abfouts/ECE_411/README.md

# ECE_411 :: T08 
Group Practicum Project
