abfouts/ECE_411/brd/README

This is the folder with the versions of the board schematic and board files
