abfouts/ECE_411/Documentation/AirplaneLGear_HW5_blockdiagrams.pdf

# High Level Block Diagram

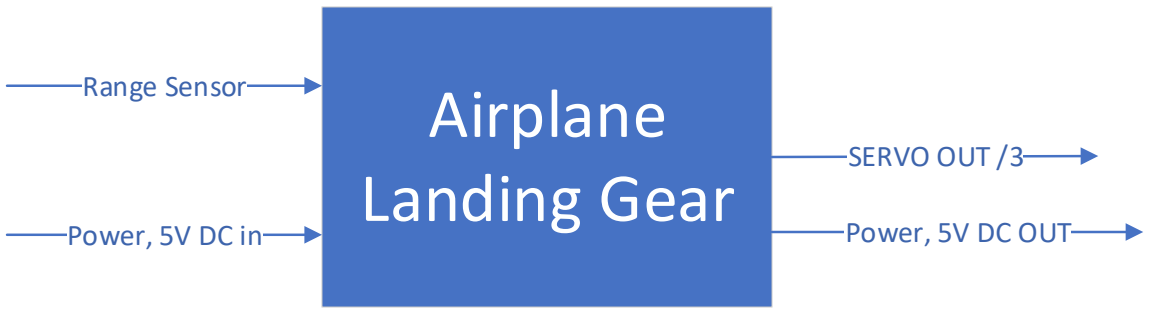
[picture p5: figure]
Airplane Landing Gear; Range Sensor; Power, 5V DC in; SERVO OUT /3; Power, 5V DC OUT

# Airplane Landing Gear: Level 1

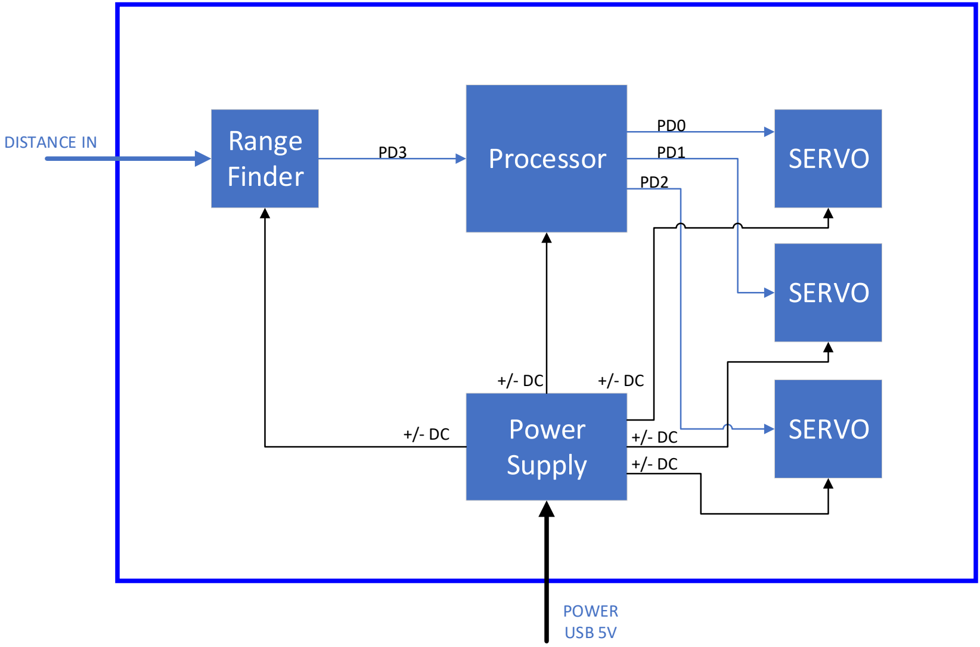
[picture p6: figure]
Processor; Power Supply; Range; Finder; SERVO; POWER USB 5V; DISTANCE IN

5V USB IN | Power Supply | 5V DC OUT
Module | Power Supply
Inputs | 5V DC USB IN: USB 5V DC input
Outputs | 5V DC OUT: Stable 5V DC
Functionality | Stabilizes the 5V USB input and outputs 5V into the necessary components

# Power Supply Level 1

Analog Distance IN | Processor | Servo Angle Out /3

Power

Module | Processor
Inputs | Analog Distance IN: Measured distance from the range finder that has been converted to analog Power: +/- 5V DC
Outputs | Servo Angle Out /3: Data out for the three servos to determine their angle
Functionality | Converts analog distance value into a digital value, and determining if the landing gear should be down (90 degrees) or up (0 or 180 degrees).

# Processor Level 1

Distance IN | Range Finder | Analog Distance OUT

Power

Module | Range Finder
Inputs | Distance IN: Measured distance from the range finder Power: +/- 5V DC
Outputs | Analog Distance: An analog voltage corresponding to the Distance IN
Functionality | Convert a measured distance to an analog value that corresponds to a voltage between 0V-5V

# Range Finder Level 1

SERVO ANGLE IN | SERVO

Power

Module | SERVO
Inputs | SERVO ANGLE IN: Measured distance from the range finder Power: +/- 5V DC
Outputs | No OUTPUT signal, but physical motor movement to display 0 to 180 degrees
Functionality | Takes a digital value input determining the angle of the servo motor (0-180 degrees)

# Servo Level 1
