abfouts/ECE_411/Documentation/Team 19 Review.pdf

Team 19 Review for Abram’s Group

First of all, great board!

Schematic:

- Didn’t have team name, version, and date on the board
- 9 warnings present on schematic, fix or approve before uploading

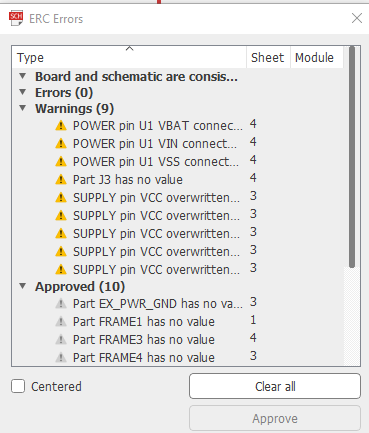
[picture p8: figure]

Board Layout:

- DRC returns no errors
- Power line traces look very good
- Board within boundary
- Vias stitched to GND
