abfouts/ECE_411/Documentation/ECE 411 BoM.xlsx

Landing Gear Bill of Materials
Ece 411 Practicum / Fall '19 Date: 3-Nov-2019
Part | Qty. | Website | Website Part Number | Manufacturer | Manufacturer Part Number | Unit Price | Total | Description | Ordered? | Paid?
SWITCH TACTILE SPST-NO 0.05A 12V | 5 | Digikey | CKN10361CT-ND (https://www.digikey.com/product-detail/en/c-k/RS-187R05A2-DS-MT-RT/CKN10361CT-ND/2747199) | C&K | RS-187R05A2-DS MT RT | $0.53 | $2.65 | Tactile Switch SPST-NO Top Actuated Surface Mount
5xAA Battery Holder | 4 | Digikey | 1528-2289-ND (https://www.digikey.com/products/en/battery-products/battery-holders-clips-contacts/86?k=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) | Adafruit Industries LLC | 3456 | $3.95 | $15.80 | Battery Holder (Open) AA 5 Cell Wire Leads - 5" (127.00mm)
Batteries | 30 | Digikey | SY628-ND (https://www.digikey.com/product-detail/en/fdk-america-inc-a-member-of-fujitsu-group/LR6-C-2S/SY628-ND/5305214) | FDK America Inc | LR6 C (2S) | $0.27 | $8.10 | AA Alkaline Manganese Dioxide 1.5V Battery Non-Rechargeable (Primary)
Capacitor - 100n | 30 | Digikey | 1276-1003-1-ND (https://www.digikey.com/product-detail/en/samsung-electro-mechanics/CL21B104KBCNNNC/1276-1003-1-ND/3889089) | Samsung Electro-Mechanics | CL21B104KBCNNNC | $0.05 | $1.53 | 0.1µF ±10% 50V Ceramic Capacitor X7R 0805 (2012 Metric)
Capacitor - 1u | 30 | Digikey | 1276-6471-1-ND (https://www.digikey.com/product-detail/en/samsung-electro-mechanics/CL21B105KOFNNNG/1276-6471-1-ND/5958099) | Samsung Electro-Mechanics | CL21B105KOFNNNG | $0.05 | $1.41 | 1µF ±10% 16V Ceramic Capacitor X7R 0805 (2012 Metric)
Capacitor - 4.7u | 20 | Digikey | 1276-1065-1-ND (https://www.digikey.com/product-detail/en/samsung-electro-mechanics/CL21A475KOFNNNE/1276-1065-1-ND/3889151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) | Samsung Electro-Mechanics | CL21A475KOFNNNE | $0.12 | $2.32 | 4.7µF ±10% 16V Ceramic Capacitor X5R 0805 (2012 Metric)
Capacitor - 470p | 5 | Digikey | 1276-1300-1-ND (https://www.digikey.com/product-detail/en/samsung-electro-mechanics/CL21B471KBANNNC/1276-1300-1-ND/3889386) | Samsung Electro-Mechanics | CL21B471KBANNNC | $0.10 | $0.50 | 470pF ±10% 50V Ceramic Capacitor X7R 0805 (2012 Metric)
Capacitor - 30p | 10 | Digikey | 311-4234-1-ND (https://www.digikey.com/product-detail/en/yageo/CC0805JRNPO9BN300/311-4234-1-ND/8025323) | Yageo | CC0805JRNPO9BN300 | $0.11 | $1.08 | 30pF ±5% 50V Ceramic Capacitor C0G, NP0 0805 (2012 Metric)
CONN HEADER SMD R/A 2POS 2MM | 5 | Digikey | 455-1749-1-ND (https://www.digikey.com/product-detail/en/jst-sales-america-inc/S2B-PH-SM4-TB-LF-SN/455-1749-1-ND/926846) | JST Sales America Inc. | S2B-PH-SM4-TB(LF)(SN) | $0.58 | $2.90 | Connector Header Surface Mount, Right Angle 2 position 0.079" (2.00mm)
CONN HEADER VERT 3POS 2.54MM | 25 | Digikey | 732-5316-ND (https://www.digikey.com/product-detail/en/w-rth-elektronik/61300311121/732-5316-ND/4846825) | Würth Elektronik | 61300311121 | $0.088 | $2.20 | Connector Header Through Hole 3 position 0.100" (2.54mm)
CONN HEADER VERT 6POS 2.54MM | 4 | Digikey | 609-3210-ND (https://www.digikey.com/product-detail/en/amphenol-icc-fci/67996-206HLF/609-3210-ND/1878485?%20Interconnects) | Amphenol ICC (FCI) | 67996-206HLF | $0.43 | $1.72 | Connector Header Through Hole 6 position 0.100" (2.54mm)
CONN RCPT TYPEB 4POS R/A | 4 | Digikey | ED2982-ND (https://www.digikey.com/product-detail/en/on-shore-technology-inc/USB-B1HSW6/ED2982-ND/2677743) | On Shore Technology Inc | USB-B1HSW6 | $0.58 | $2.32 | USB - B Receptacle Connector 4 Position Through Hole, Right Angle
CRYSTAL 16.000 MHZ 18PF SMD | 5 | Digikey | XC2081CT-ND (https://www.digikey.com/product-detail/en/ecs-inc/ECS-160-18-5PX-TR/XC2081CT-ND/5875565) | ECS Inc. | ECS-160-18-5PX-TR | $0.30 | $1.50 | 16MHz ±30ppm Crystal 18pF 40 Ohms HC-49/US
Diodes 40V 1A SMA | 10 | Digikey | B340AE-13DICT-ND (https://www.digikey.com/product-detail/en/diodes-incorporated/B340AE-13/B340AE-13DICT-ND/8545850) | Diodes Incorporated | B340AE-13 | $0.30 | $2.98 | Diode Schottky 40V 2A Surface Mount SMA
IC CONTROLLR LI-ION 4.2V SOT23-5 | 5 | Digikey | MCP73831T-2ACI/OTCT-ND (https://www.digikey.com/product-detail/en/microchip-technology/MCP73831T-2ACI-OT/MCP73831T-2ACI-OTCT-ND/1979802) | Microchip Technology | MCP73831T-2ACI/OT | $0.56 | $2.80 | Charger IC Lithium Ion/Polymer SOT-23-5
IC MCU 8BIT 32KB FLASH 44TQFP | 4 | Digikey | ATMEGA32U4-AURCT-ND (https://www.digikey.com/product-detail/en/microchip-technology/ATMEGA32U4-AUR/ATMEGA32U4-AURCT-ND/3440960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) | Microchip Technology | ATMEGA32U4-AUR | $4.20 | $16.80 | AVR AVR® ATmega Microcontroller IC 8-Bit 16MHz 32KB (16K x 16) FLASH 44-TQFP (10x10)
IC REG LINEAR 3.3V 500MA SOT23-5 | 5 | Digikey | 576-1281-1-ND (https://www.digikey.com/product-detail/en/microchip-technology/MIC5219-3.3YM5-TR/576-1281-1-ND/771902) | Microchip Technology | MIC5219-3.3YM5-TR | $0.89 | $4.45 | Linear Voltage Regulator IC 1 Output 500mA SOT-23-5
LED Green Clear 0805 SMD | 25 | Digikey | 732-4983-1-ND (https://www.digikey.com/product-detail/en/w-rth-elektronik/150080GS75000/732-4983-1-ND/4489913) | Würth Elektronik | 150080GS75000 | $0.18 | $4.50 | Green 520nm LED Indication - Discrete 3.2V 0805 (2012 Metric)
Plastic Roll 2mm Dia Shaft Toys Wheel and 25Pcs STEM Shaft Round Rod Axles | 1 | Amazon | B07QRX23TC (https://www.amazon.com/EUDAX-50pcs-Plastic-Shaft-Helicopter/dp/B07QRX23TC) | EUDAX | [--] | $11.99 | $11.99 | Shaft Dia: 1.95mm/0.08"". Suitable for 2mm shaft Diameter: 42mm / 1.65 "". Tire width: 19mm / 0.74 "". STEM shaft Features： -Length 100mm/3.9"" -Diameter 2mm/0.08""
RES SMD 10K OHM 1% 1/8W 0805 | 20 | Digikey | 311-10.0KCRCT-ND (https://www.digikey.com/product-detail/en/yageo/RC0805FR-0710KL/311-10.0KCRCT-ND/730482?slid=) | Yageo | RC0805FR-0710KL | $0.04 | $0.72 | 10 kOhms ±1% 0.125W, 1/8W Chip Resistor 0805 (2012 Metric) Moisture Resistant Thick Film
RES SMD 1K OHM 1% 1/8W 0805 | 30 | Digikey | 311-1.00KCRCT-ND (https://www.digikey.com/product-detail/en/yageo/RC0805FR-071KL/311-1.00KCRCT-ND/730391?slid=) | Yageo | RC0805FR-071KL | $0.04 | $1.11 | 1 kOhms ±1% 0.125W, 1/8W Chip Resistor 0805 (2012 Metric) Moisture Resistant Thick Film
RES SMD 22 OHM 1% 1/8W 0805 | 10 | Digikey | 311-22.0CRCT-ND (https://www.digikey.com/product-detail/en/yageo/RC0805FR-0722RL/311-22.0CRCT-ND/730682?slid=) | Yageo | RC0805FR-0722RL | $0.04 | $0.40 | 22 Ohms ±1% 0.125W, 1/8W Chip Resistor 0805 (2012 Metric) Moisture Resistant Thick Film
SENSOR OPTICAL 80CM DIGITAL | 4 | Digikey | 1855-1063-ND (https://www.digikey.com/product-detail/en/sharp-socle-technology/GP2Y0D02YK0F/1855-1063-ND/720160) | SHARP / SoCle Technology | GP2Y0D02YK0F | $10.86 | $43.44 | Optical Sensor 80cm Digital Output
SERVOMOTOR 5VDC TOWERPRO SG92R | 12 | Digikey | 1528-1076-ND (https://www.digikey.com/product-detail/en/adafruit-industries-llc/169/1528-1076-ND/5154651) | Adafruit Industries LLC | 169 | $5.95 | $71.40 | Positional Rotation DC Motor Servomotor, RC (Hobby) 5VDC
SWITCH SLIDE DPDT 100MA 12V | 5 | Digikey | 401-2013-1-ND (https://www.digikey.com/product-detail/en/c-k/AYZ0202AGRLC/401-2013-1-ND/1640122?slid=) | C&K | AYZ0202AGRLC | $1.43 | $7.15 | Slide Switch DPDT Surface Mount
Total |  |  |  |  |  | $43.62 | $211.77
