abfouts/ECE_411/brd/minimal-atmega32u4-arduino.brd

## EAGLE design brd/minimal-atmega32u4-arduino.brd (2019-12-09)

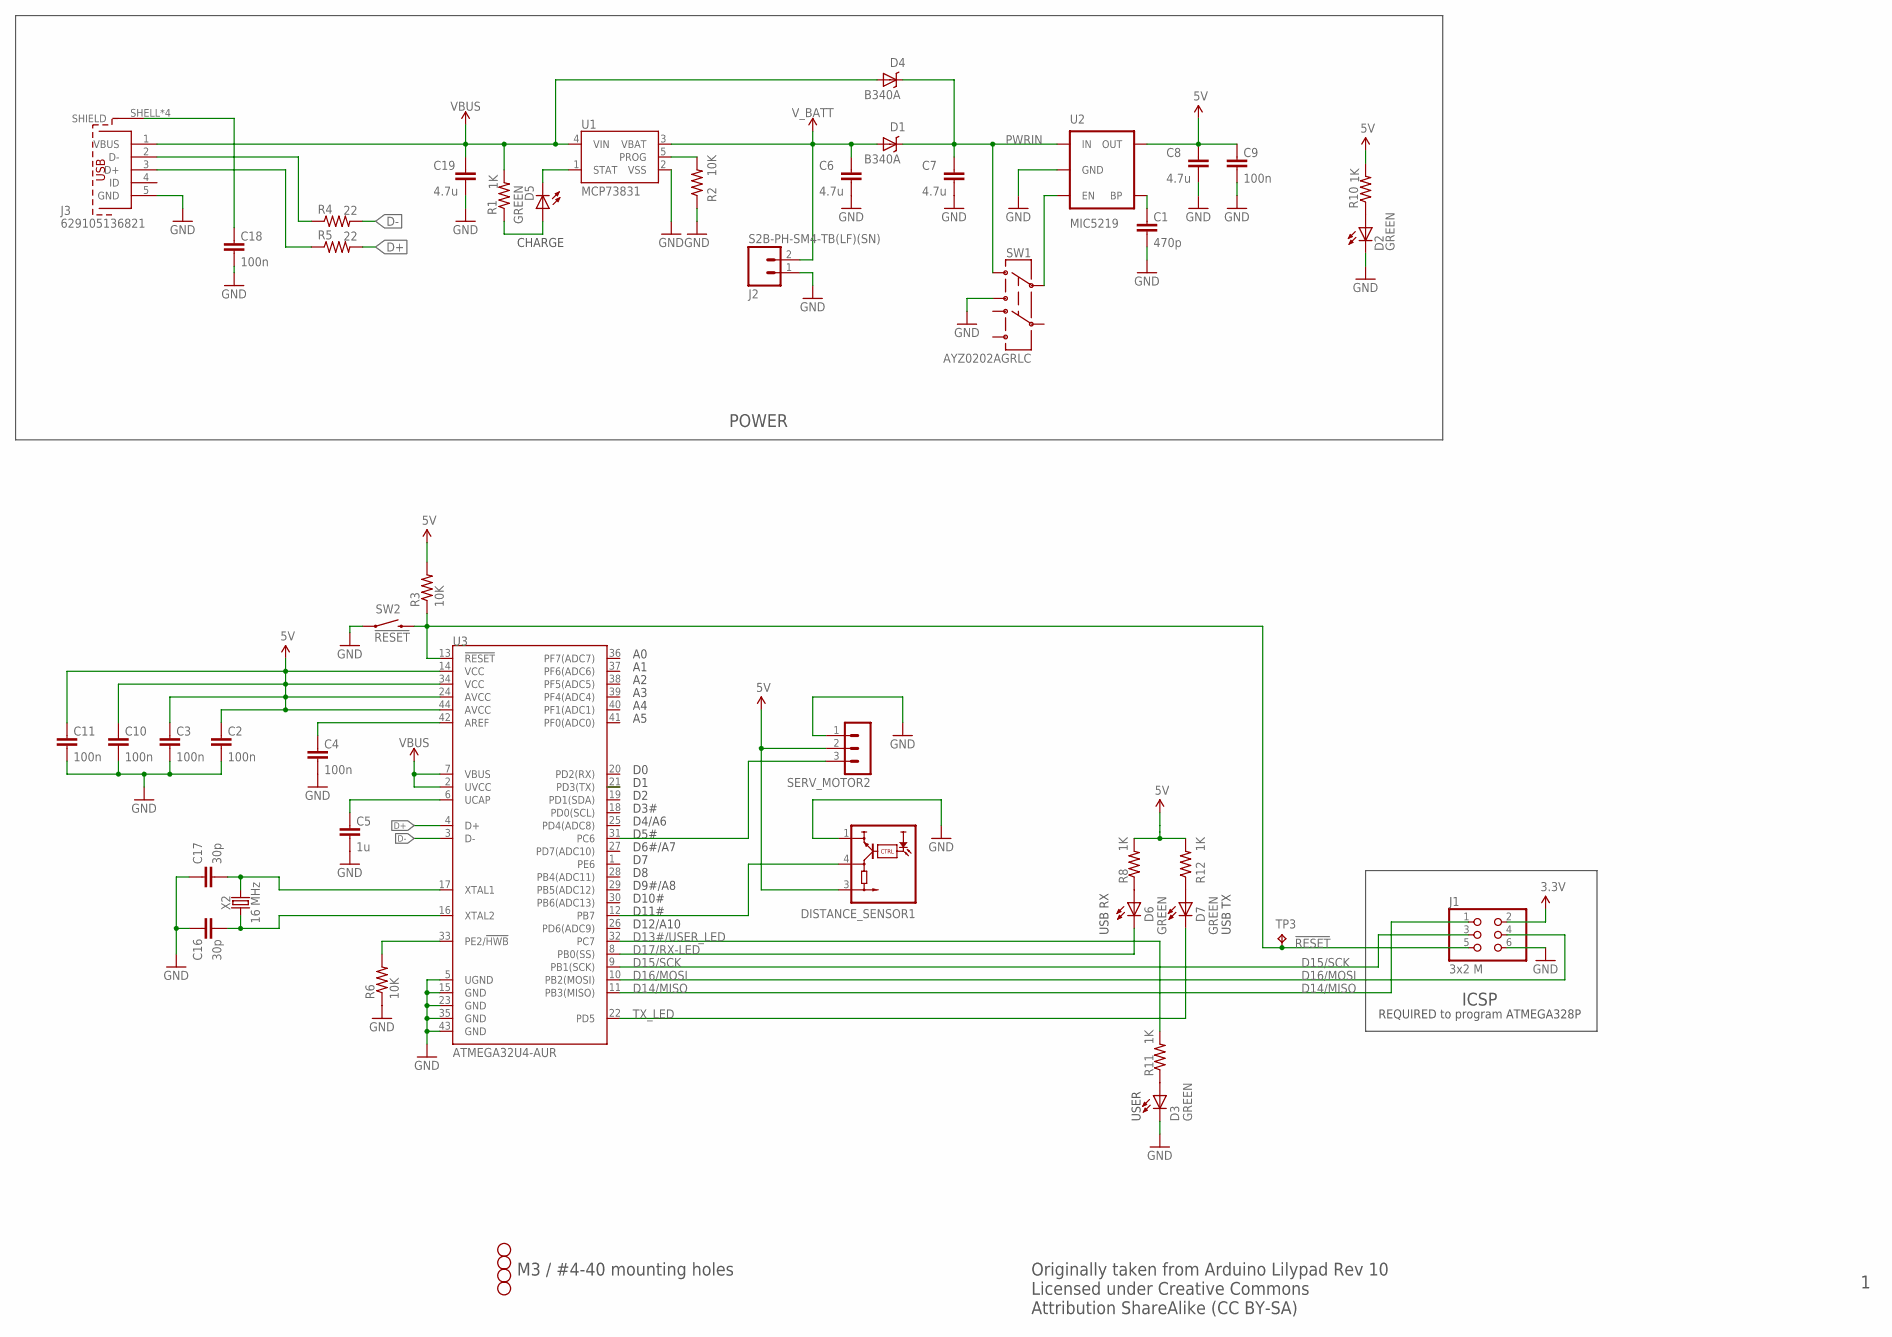
[picture p9: schematic minimal-atmega32u4-arduino.sch, sheet 1]

Parts:
C1: 470p; C0805K; MPN CL21B471KBANNNC
C2, C3, C4, C9, C10, C11, C18: 100n; C0805K; MPN CL21B104KBCNNNC
C5: 1u; C0805K; MPN CL21B105KOFNNNG
C6, C7, C8, C19: 4.7u; C0805K; MPN CL21A475KOFNNNE
C16: 30p; C0805K; MPN CL21C300JBANNNC
C17: 30p; C0805K; MPN CL21C180JBANNNC
D1, D4: B340A; SMA-DIODE; MPN B340AE-13
D2, D3, D5, D6, D7: GREEN; CHIP-LED0805; MPN 150080GS75000
DISTANCE_SENSOR1: TSSP6P38
H1, H2, H3, H4: STAND-OFF
J1: 3x2 M; 2X03; MPN M20-9980345
J2: S2B-PH-SM4-TB(LF)(SN); JST-2-SMD; MPN S2B-PH-SM4-TB(LF)(SN)
J3: 629105136821; MPN 629105136821
R1, R8, R10, R11, R12: 1K; R0805; MPN RC0805FR-071KL
R2, R3, R6: 10K; R0805; MPN RC0805FR-0710KL
R4, R5: 22; R0805; MPN RC0805FR-0722RL
SERV_MOTOR2: MA03-1
SW1: AYZ0202AGRLC; AYZ0202; MPN AYZ0202AGRLC
SW2: !RESET; TACTILE_SWITCH_SMD; MPN RS-187R05A2-DS MT RT
TP3: TPPAD1-13; P1-13
U1: MCP73831; SOT23-5; MPN MCP73831T-2ACI/OT
U2: MIC5219; SOT23-5; MPN MIC5219-3.3YM5-TR
U3: ATMEGA32U4-AUR; TQFP44; MPN ATMEGA32U4-AUR
X2: 16 MHz; HC49UP; MPN ECS-160-18-5PX-TR

Connections:
3.3V: C2.1, C3.1, C8.1, C9.1, C10.1, C11.1, J1.2, R3.2, R8.2, R10.2, R12.2, U2.5 (OUT), U3.14 (VCC), U3.24 (AVCC), U3.34 (VCC), U3.44 (AVCC)
3.3V3: DISTANCE_SENSOR1.3 (VS), SERV_MOTOR2.2
!RESET: J1.5, R3.1, SW2.3 (2), TP3.TP, U3.13 (!RESET)
AREF: C4.1, U3.42 (AREF)
D13#/USER_LED: R11.2, U3.32 (PC7)
D14/MISO: J1.1, U3.11 (PB3(MISO))
D15/SCK: J1.3, U3.9 (PB1(SCK))
D16/MOSI: J1.4, U3.10 (PB2(MOSI))
D17/RX-LED: D6.C, U3.8 (PB0(SS))
D+: R5.2, U3.4 (D+)
D-: R4.2, U3.3 (D-)
GND: C1.2, C2.2, C3.2, C4.2, C5.2, C6.2, C7.2, C8.2, C9.2, C10.2, C11.2, C16.2, C17.2, C18.2, C19.2, D2.C, D3.C, DISTANCE_SENSOR1.1 (GND), J1.6, J2.1 (2), J3.5 (GND), R2.1, R6.1, SERV_MOTOR2.1, SW1.3, SW2.1, U1.2 (VSS), U2.2 (GND), U3.5 (UGND), U3.15 (GND), U3.23 (GND), U3.35 (GND), U3.43 (GND)
GND1: SERV_MOTOR2.3, U3.31 (PC6)
MCPPROG: R2.2, U1.5 (PROG)
MIC-BP: C1.1, U2.4 (BP)
MIC-EN: SW1.2, U2.3 (EN)
unnamed: DISTANCE_SENSOR1.4 (OUT), U3.12 (PB7)
unnamed: D5.A, R1.1
unnamed: D5.C, U1.1 (STAT)
unnamed: D2.A, R10.1
unnamed: D3.A, R11.1
unnamed: C18.1, J3.SHELL (SHIELD), J3.SHELL1 (SHIELD), J3.SHELL2 (SHIELD), J3.SHELL3 (SHIELD)
unnamed: D6.A, R8.1
unnamed: D7.A, R12.1
unnamed: J3.2 (D-), R4.1
unnamed: J3.3 (D+), R5.1
PE2/!HWB: R6.2, U3.33 (PE2/!HWB)
PWRIN: C7.1, D1.C, D4.C, SW1.1, U2.1 (IN)
TX_LED: D7.C, U3.22 (PD5)
UCAP: C5.1, U3.6 (UCAP)
VBUS: C19.1, D4.A, J3.1 (VBUS), R1.2, U1.4 (VIN), U3.2 (UVCC), U3.7 (VBUS)
V_BATT: C6.1, D1.A, J2.2 (1), U1.3 (VBAT)
XTAL1: C17.1, U3.17 (XTAL1), X2.2
XTAL2: C16.1, U3.16 (XTAL2), X2.1

Notes on the sheet:
CHARGE
Originally taken from Arduino Lilypad Rev 10 Licensed under Creative Commons Attribution ShareAlike (CC BY-SA)
POWER
M3 / #4-40 mounting holes
ICSP
REQUIRED to program ATMEGA328P
USB RX
USB TX
USER
D3#
D4/A6
D5#
D6#/A7
D9#/A8
D10#
D11#
D12/A10

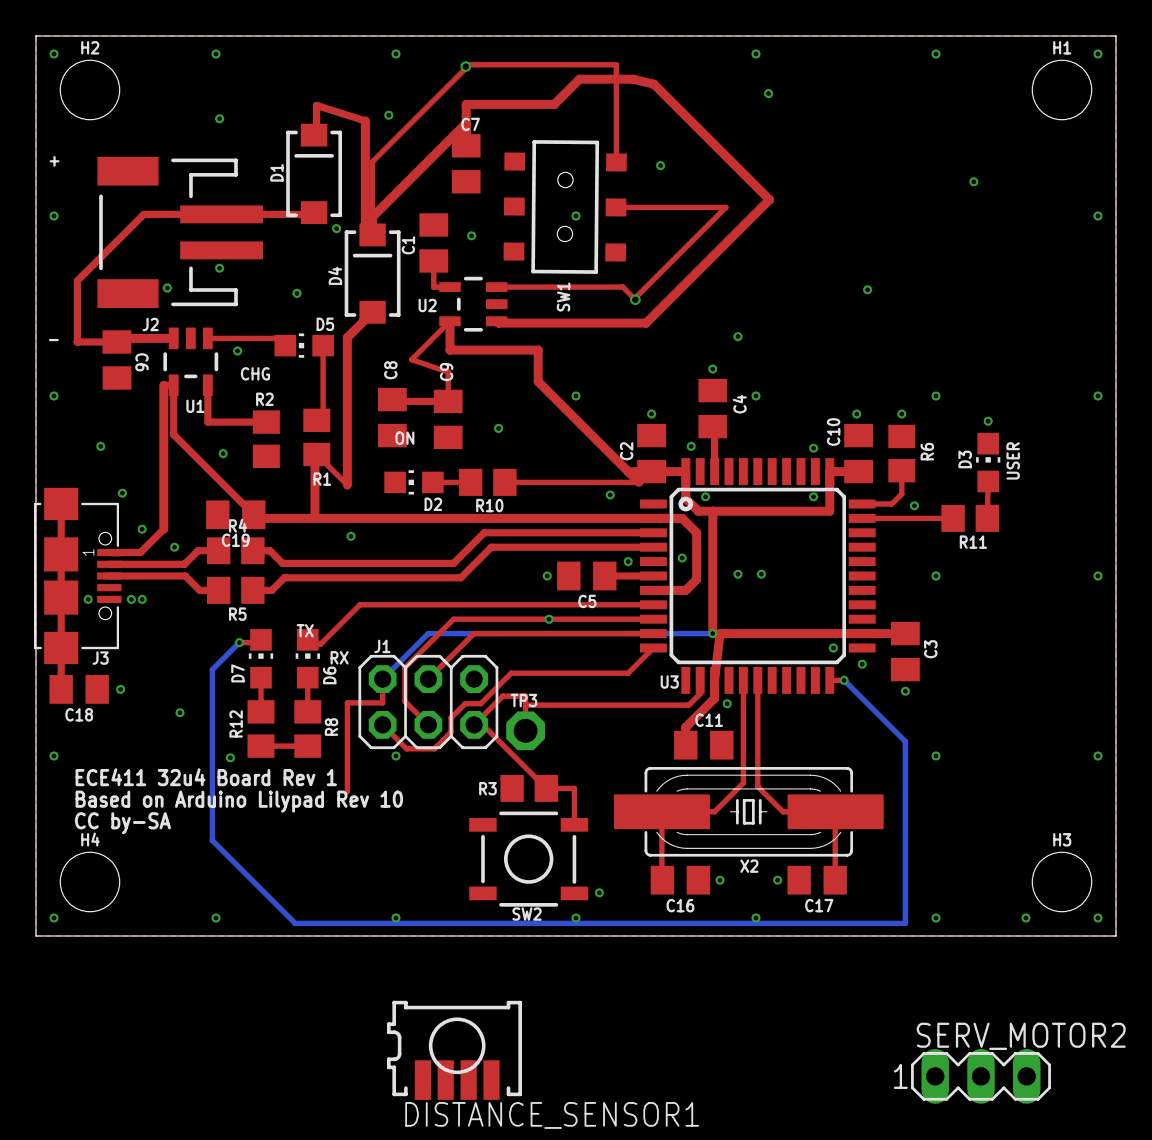
[picture p10: board minimal-atmega32u4-arduino.brd from above]

Board: 2 copper layers, 60.0 x 50.0 mm, 48 parts (0 on the bottom side), 34 nets.
