abfouts/ECE_411/brd/LandingGearSchematic_3.brd

## EAGLE design brd/LandingGearSchematic_3.brd (2019-12-02)

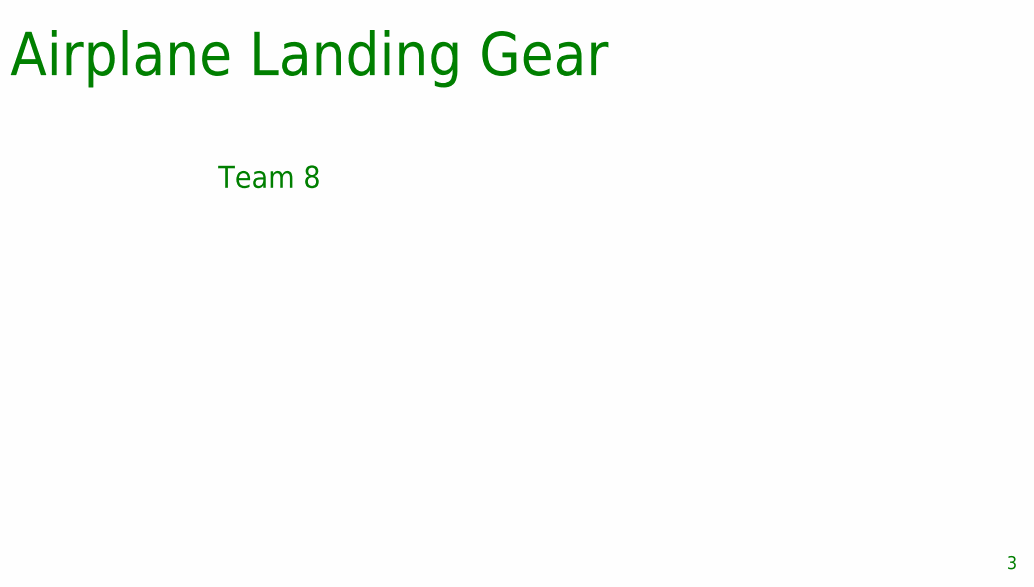
[picture p11: schematic LandingGearSchematic_3.sch, sheet 1, Title]

Notes on the sheet:
Airplane Landing Gear
Team 8

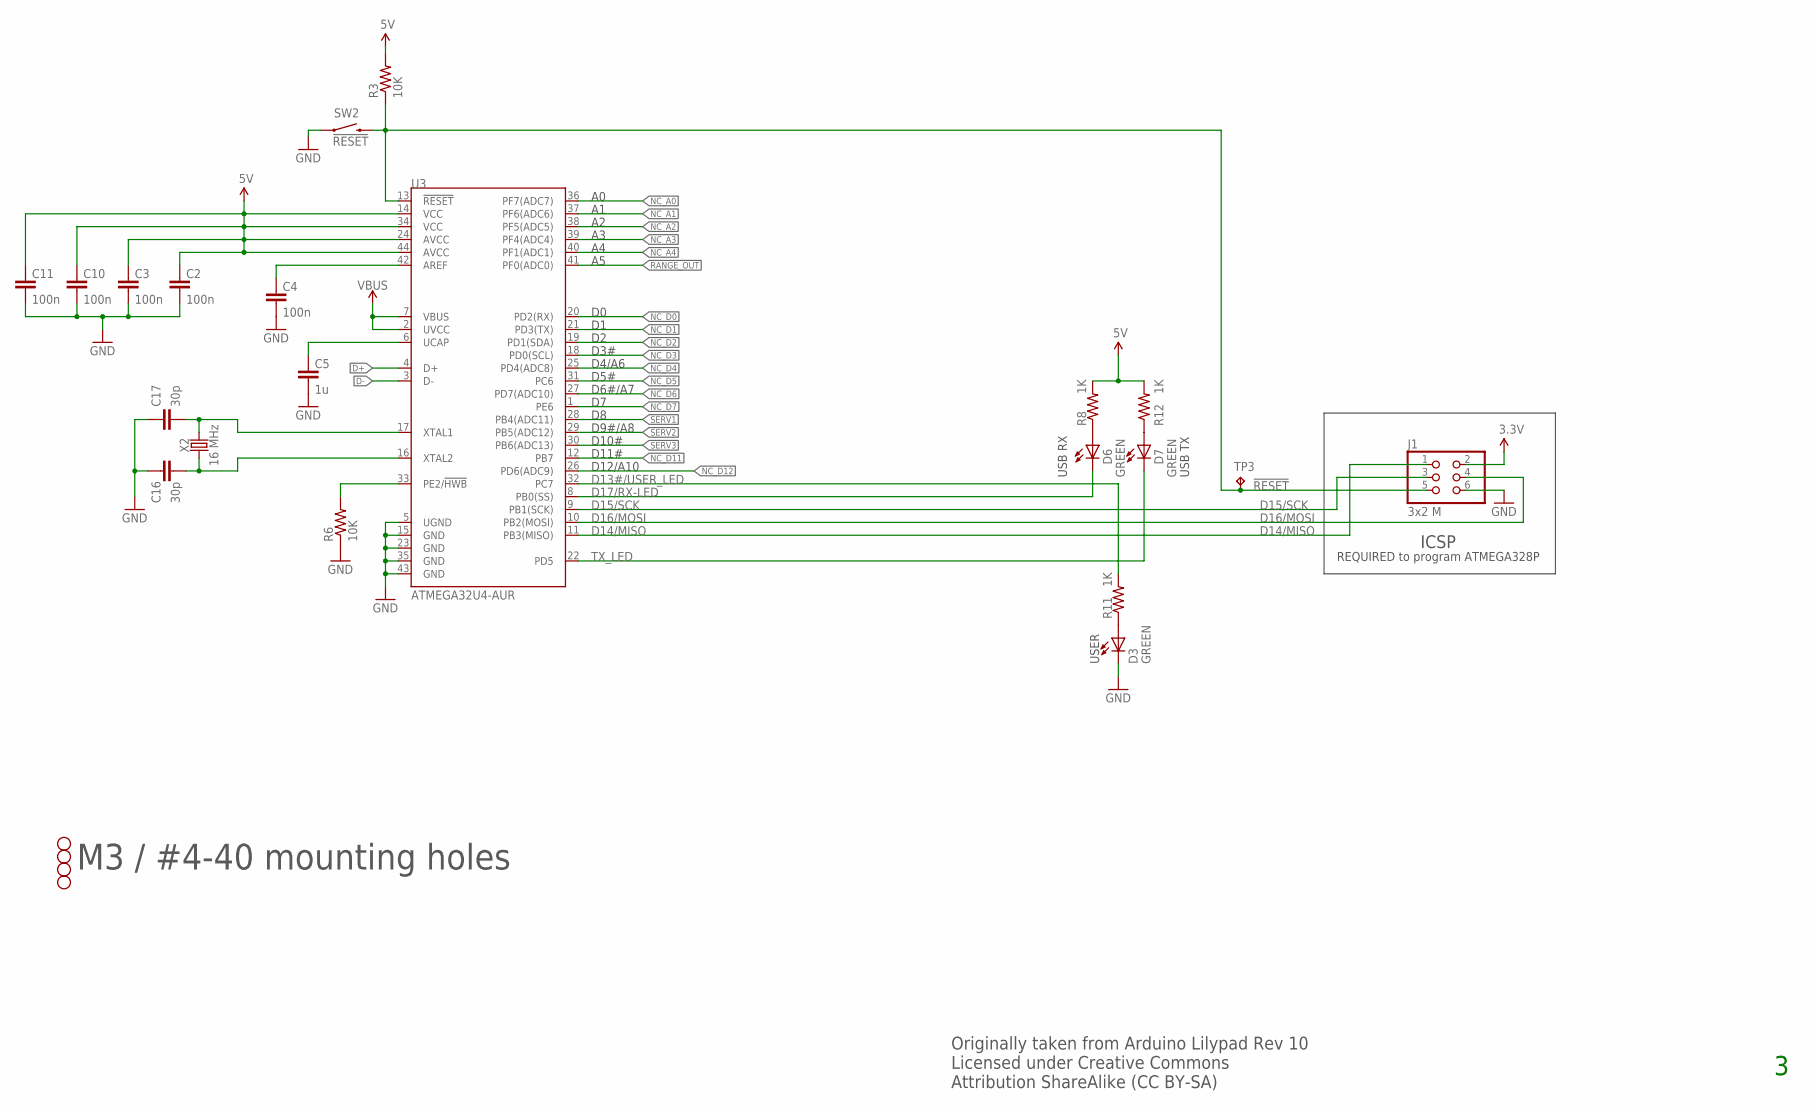
[picture p12: schematic LandingGearSchematic_3.sch, sheet 2, Processor(1 of 1)]

Parts:
C2, C3, C4, C10, C11: 100n; C0805K; MPN CL21B104KBCNNNC
C5: 1u; C0805K; MPN CL21B105KOFNNNG
C16: 30p; C0805K; MPN CL21C300JBANNNC
C17: 30p; C0805K; MPN CL21C180JBANNNC
D3, D6, D7: GREEN; CHIP-LED0805; MPN 150080GS75000
H1, H2, H3, H4: STAND-OFF
J1: 3x2 M; 2X03; MPN M20-9980345
R3, R6: 10K; R0805; MPN RC0805FR-0710KL
R8, R11, R12: 1K; R0805; MPN RC0805FR-071KL
SW2: !RESET; TACTILE_SWITCH_SMD; MPN RS-187R05A2-DS MT RT
TP3: TPPAD1-13; P1-13
U3: ATMEGA32U4-AUR; TQFP44; MPN ATMEGA32U4-AUR
X2: 16 MHz; HC49UP; MPN ECS-160-18-5PX-TR

Connections:
3.3V: C2.1, C3.1, C10.1, C11.1, J1.2, R3.2, R8.2, R12.2, U3.14 (VCC), U3.24 (AVCC), U3.34 (VCC), U3.44 (AVCC); also elsewhere on the board
!RESET: J1.5, R3.1, SW2.3 (2), TP3.TP, U3.13 (!RESET)
AREF: C4.1, U3.42 (AREF)
D13#/USER_LED: R11.2, U3.32 (PC7)
D14/MISO: J1.1, U3.11 (PB3(MISO))
D15/SCK: J1.3, U3.9 (PB1(SCK))
D16/MOSI: J1.4, U3.10 (PB2(MOSI))
D17/RX-LED: D6.C, U3.8 (PB0(SS))
D+: U3.4 (D+); also elsewhere on the board
D-: U3.3 (D-); also elsewhere on the board
GND: C2.2, C3.2, C4.2, C5.2, C10.2, C11.2, C16.2, C17.2, D3.C, J1.6, R6.1, SW2.1, U3.5 (UGND), U3.15 (GND), U3.23 (GND), U3.35 (GND), U3.43 (GND); also elsewhere on the board
unnamed: D3.A, R11.1
unnamed: D6.A, R8.1
unnamed: D7.A, R12.1
NC_A0: U3.36 (PF7(ADC7)); also elsewhere on the board
NC_A1: U3.37 (PF6(ADC6)); also elsewhere on the board
NC_A2: U3.38 (PF5(ADC5)); also elsewhere on the board
NC_A3: U3.39 (PF4(ADC4)); also elsewhere on the board
NC_A4: U3.40 (PF1(ADC1)); also elsewhere on the board
NC_D0: U3.20 (PD2(RX)); also elsewhere on the board
NC_D1: U3.21 (PD3(TX)); also elsewhere on the board
NC_D2: U3.19 (PD1(SDA)); also elsewhere on the board
NC_D3: U3.18 (PD0(SCL)); also elsewhere on the board
NC_D4: U3.25 (PD4(ADC8)); also elsewhere on the board
NC_D5: U3.31 (PC6); also elsewhere on the board
NC_D6: U3.27 (PD7(ADC10)); also elsewhere on the board
NC_D7: U3.1 (PE6); also elsewhere on the board
NC_D11: U3.12 (PB7); also elsewhere on the board
NC_D12: U3.26 (PD6(ADC9)); also elsewhere on the board
PE2/!HWB: R6.2, U3.33 (PE2/!HWB)
RANGE_OUT: U3.41 (PF0(ADC0)); also elsewhere on the board
SERV1: U3.28 (PB4(ADC11)); also elsewhere on the board
SERV2: U3.29 (PB5(ADC12)); also elsewhere on the board
SERV3: U3.30 (PB6(ADC13)); also elsewhere on the board
TX_LED: D7.C, U3.22 (PD5)
UCAP: C5.1, U3.6 (UCAP)
VBUS: U3.2 (UVCC), U3.7 (VBUS); also elsewhere on the board
XTAL1: C17.1, U3.17 (XTAL1), X2.2
XTAL2: C16.1, U3.16 (XTAL2), X2.1

Notes on the sheet:
Originally taken from Arduino Lilypad Rev 10 Licensed under Creative Commons Attribution ShareAlike (CC BY-SA)
M3 / #4-40 mounting holes
ICSP
REQUIRED to program ATMEGA328P
USB RX
USB TX
USER
D3#
D4/A6
D5#
D6#/A7
D9#/A8
D10#
D11#
D12/A10

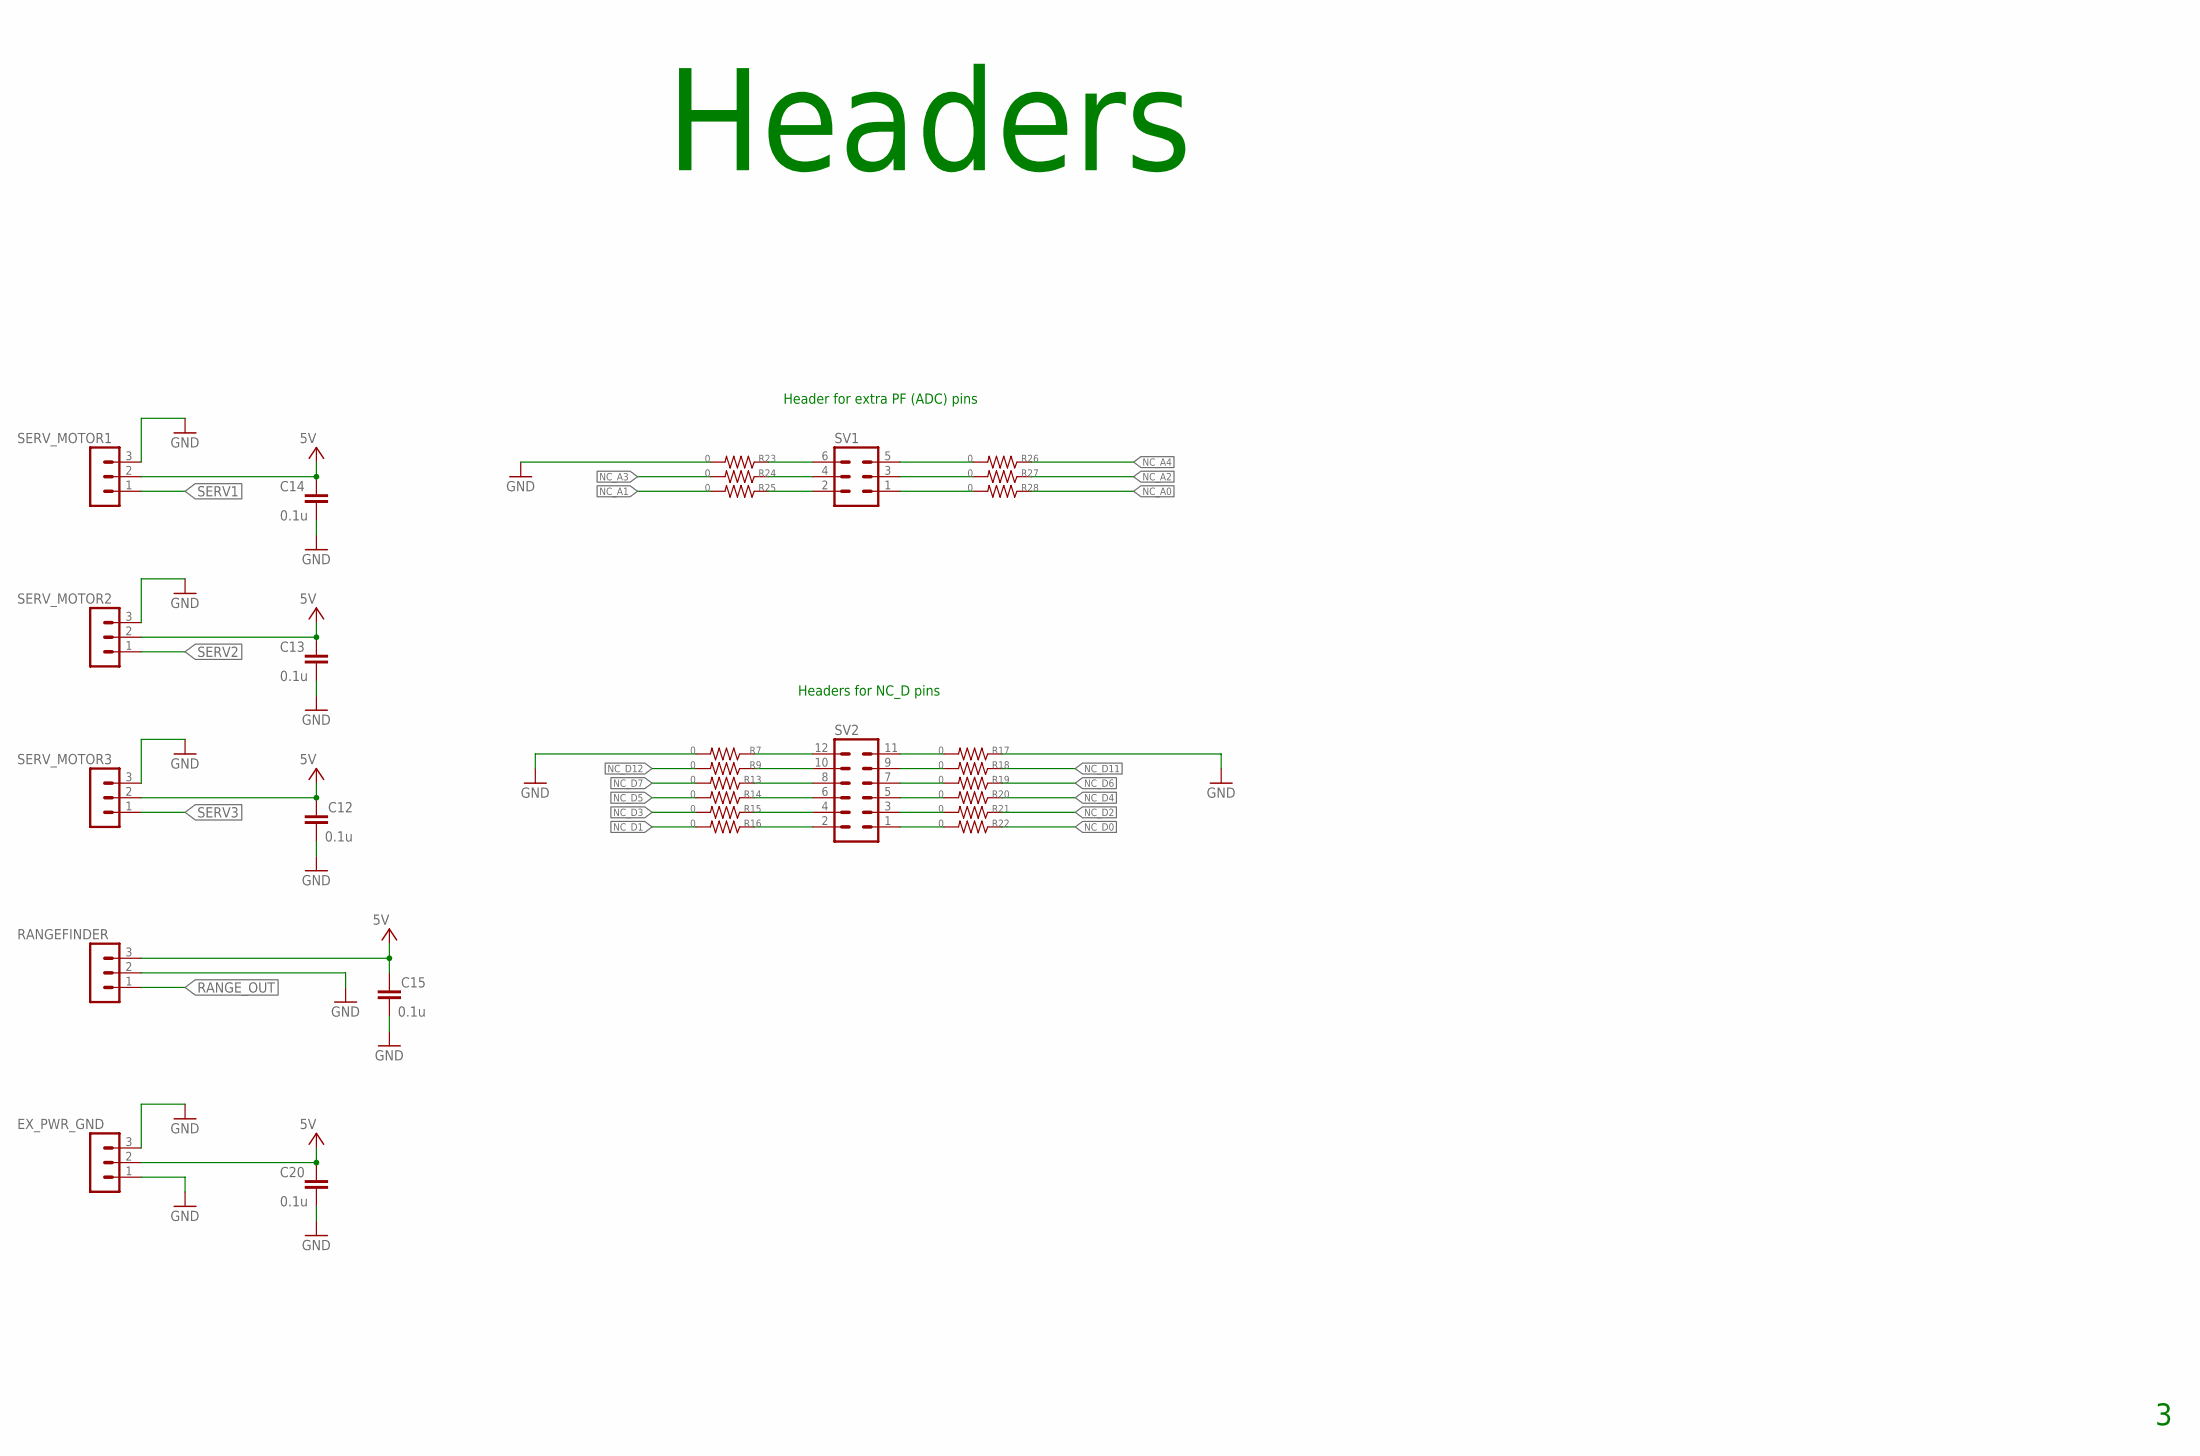
[picture p13: schematic LandingGearSchematic_3.sch, sheet 3, Headers (1 of 1)]

Parts:
C12, C13, C14, C15, C20: 0.1u; C0805K; MPN CL21B105KOFNNNG
EX_PWR_GND: MA03-1
R7, R9, R13, R14, R15, R16, R17, R18, R19, R20, R21, R22, R23, R24, R25, R26, R27, R28: 0; R0805; MPN RC0805FR-071KL
RANGEFINDER: MA03-1
SERV_MOTOR1, SERV_MOTOR2, SERV_MOTOR3: MA03-1
SV1: MA03-2
SV2: MA06-2

Connections:
GND: C12.2, C13.2, C14.2, C15.2, C20.2, EX_PWR_GND.1, EX_PWR_GND.3, R7.2, R17.1, R23.2, RANGEFINDER.2, SERV_MOTOR1.3, SERV_MOTOR2.3, SERV_MOTOR3.3; also elsewhere on the board
unnamed: R7.1, SV2.12
unnamed: R17.2, SV2.11
unnamed: R23.1, SV1.6
NC_A0: R28.1; also elsewhere on the board
NC_A0_R: R28.2, SV1.1
NC_A1: R25.2; also elsewhere on the board
NC_A1_R: R25.1, SV1.2
NC_A2: R27.1; also elsewhere on the board
NC_A2_R: R27.2, SV1.3
NC_A3: R24.2; also elsewhere on the board
NC_A3_R: R24.1, SV1.4
NC_A4: R26.1; also elsewhere on the board
NC_A4_R: R26.2, SV1.5
NC_D0: R22.1; also elsewhere on the board
NC_D0_R: R22.2, SV2.1
NC_D1: R16.2; also elsewhere on the board
NC_D1_R: R16.1, SV2.2
NC_D2: R21.1; also elsewhere on the board
NC_D2_R: R21.2, SV2.3
NC_D3: R15.2; also elsewhere on the board
NC_D3_R: R15.1, SV2.4
NC_D4: R20.1; also elsewhere on the board
NC_D4_R: R20.2, SV2.5
NC_D5: R14.2; also elsewhere on the board
NC_D6: R19.1; also elsewhere on the board
NC_D6_R: R19.2, SV2.7
NC_D7: R13.2; also elsewhere on the board
NC_D7_R: R13.1, SV2.8
NC_D11: R18.1; also elsewhere on the board
NC_D11_R: R18.2, SV2.9
NC_D12: R9.2; also elsewhere on the board
NC_D12_R: R9.1, SV2.10
ND_D5_R: R14.1, SV2.6
RANGE_OUT: RANGEFINDER.1; also elsewhere on the board
SERV1: SERV_MOTOR1.1; also elsewhere on the board
SERV2: SERV_MOTOR2.1; also elsewhere on the board
SERV3: SERV_MOTOR3.1; also elsewhere on the board
VCC: C12.1, C13.1, C14.1, C15.1, C20.1, EX_PWR_GND.2, RANGEFINDER.3, SERV_MOTOR1.2, SERV_MOTOR2.2, SERV_MOTOR3.2

Notes on the sheet:
Headers
Header for extra PF (ADC) pins
Headers for NC_D pins

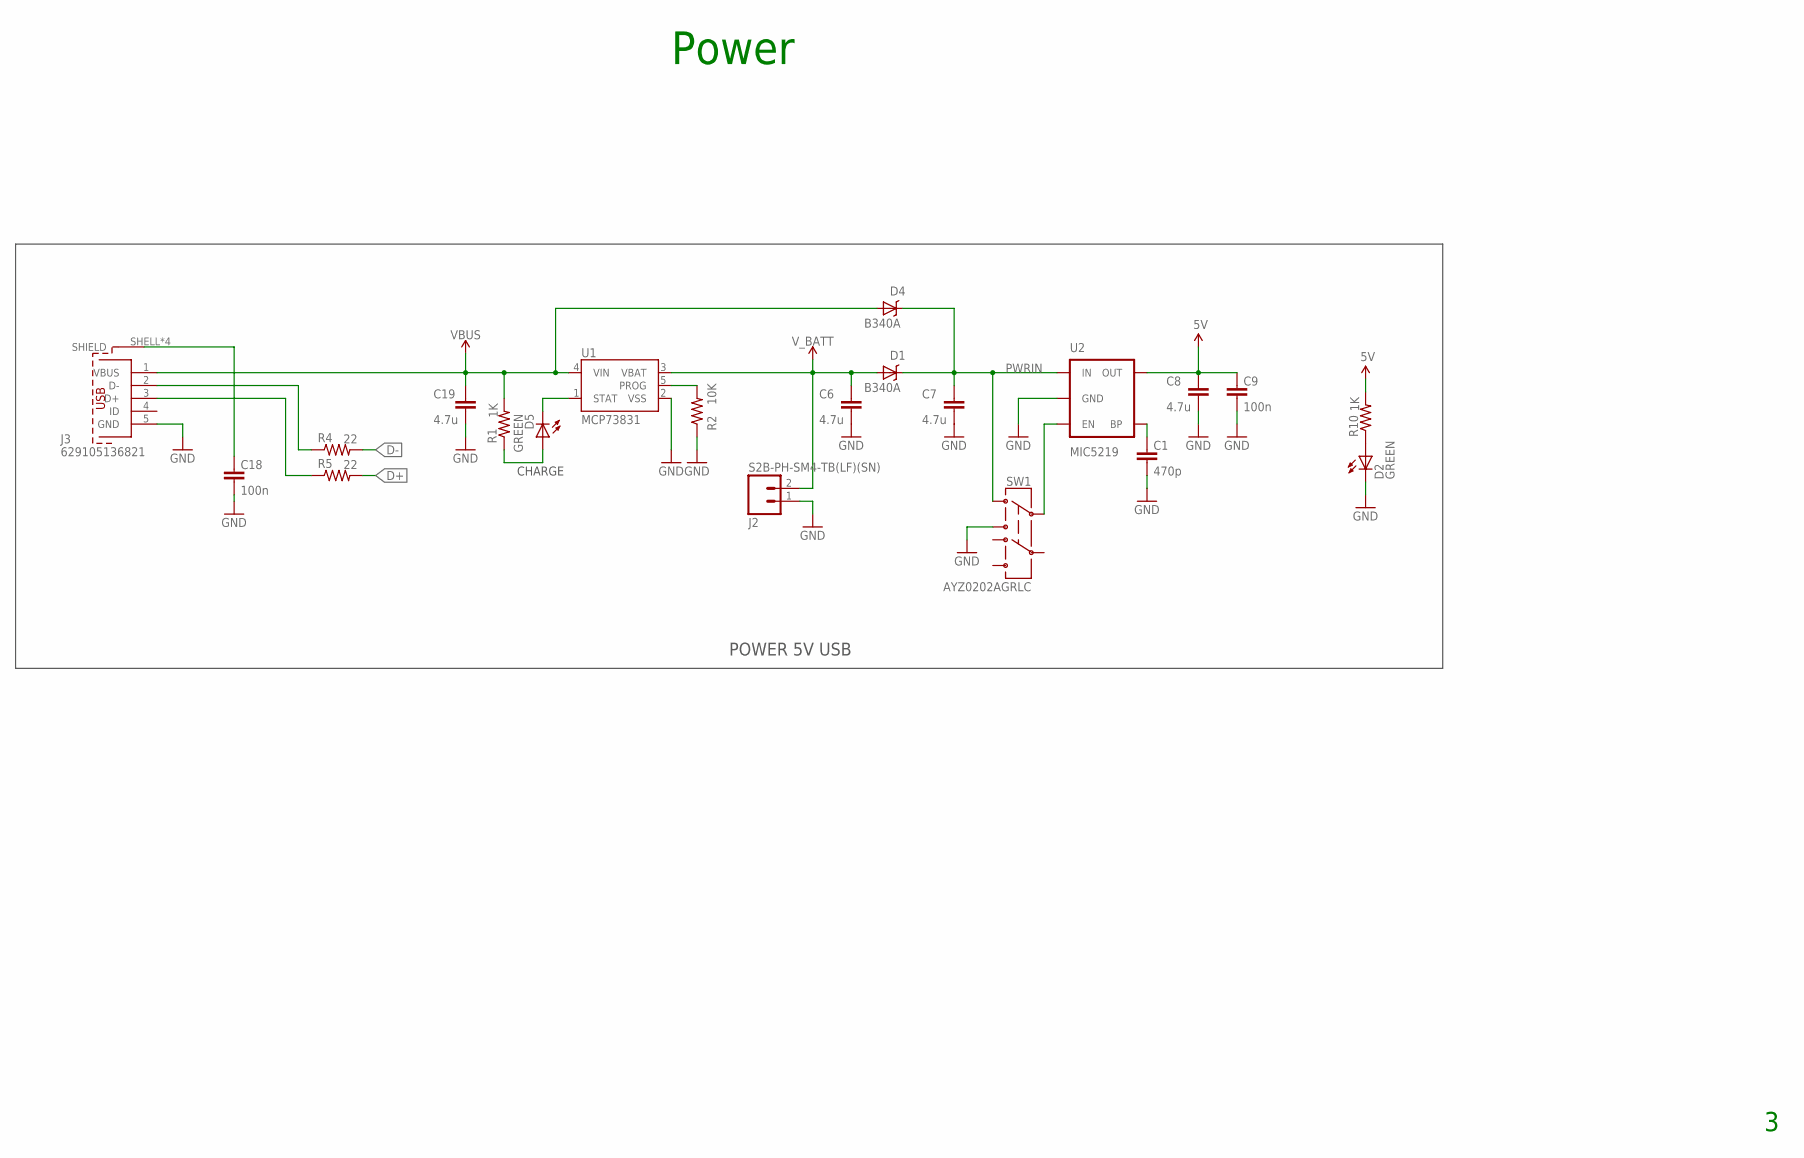
[picture p14: schematic LandingGearSchematic_3.sch, sheet 4, Power (1 of 1)]

Parts:
C1: 470p; C0805K; MPN CL21B471KBANNNC
C6, C7, C8, C19: 4.7u; C0805K; MPN CL21A475KOFNNNE
C9, C18: 100n; C0805K; MPN CL21B104KBCNNNC
D1, D4: B340A; SMA-DIODE; MPN B340AE-13
D2, D5: GREEN; CHIP-LED0805; MPN 150080GS75000
J2: S2B-PH-SM4-TB(LF)(SN); JST-2-SMD; MPN S2B-PH-SM4-TB(LF)(SN)
J3: 629105136821; MPN 629105136821
R1, R10: 1K; R0805; MPN RC0805FR-071KL
R2: 10K; R0805; MPN RC0805FR-0710KL
R4, R5: 22; R0805; MPN RC0805FR-0722RL
SW1: AYZ0202AGRLC; AYZ0202; MPN AYZ0202AGRLC
U1: MCP73831; SOT23-5; MPN MCP73831T-2ACI/OT
U2: MIC5219; SOT23-5; MPN MIC5219-3.3YM5-TR

Connections:
3.3V: C8.1, C9.1, R10.2, U2.5 (OUT); also elsewhere on the board
D+: R5.2; also elsewhere on the board
D-: R4.2; also elsewhere on the board
GND: C1.2, C6.2, C7.2, C8.2, C9.2, C18.2, C19.2, D2.C, J2.1 (2), J3.5 (GND), R2.1, SW1.3, U1.2 (VSS), U2.2 (GND); also elsewhere on the board
MCPPROG: R2.2, U1.5 (PROG)
MIC-BP: C1.1, U2.4 (BP)
MIC-EN: SW1.2, U2.3 (EN)
unnamed: D5.A, R1.1
unnamed: D5.C, U1.1 (STAT)
unnamed: D2.A, R10.1
unnamed: C18.1, J3.SHELL (SHIELD), J3.SHELL1 (SHIELD), J3.SHELL2 (SHIELD), J3.SHELL3 (SHIELD)
unnamed: J3.2 (D-), R4.1
unnamed: J3.3 (D+), R5.1
PWRIN: C7.1, D1.C, D4.C, SW1.1, U2.1 (IN)
VBUS: C19.1, D4.A, J3.1 (VBUS), R1.2, U1.4 (VIN); also elsewhere on the board
V_BATT: C6.1, D1.A, J2.2 (1), U1.3 (VBAT)

Notes on the sheet:
Power
CHARGE
POWER 5V USB

Board: 2 copper layers, 76 parts (0 on the bottom side), 69 nets, no tracks yet.
