abfouts/ECE_411/(commit log)

2019-10-23 Add files via upload
    Initial buildout of BoM
    [ECE 411 BoM.xlsx]
2019-10-23 Delete ECE 411 BoM.xlsx
    Wrong Branch
    [ECE 411 BoM.xlsx]
2019-10-31 Create Schematics
2019-12-02 Add files via upload
    Moved everything to MASTER branch
    [ECE 411 BoM.xlsx, Landing Gear Layout REV.sch, Landing Gear Layout.brd, Landing Gear Layout.sch, Landing Gear Schematic.brd, Landing Gear Schematic.sch, LandingGearSchematic_2.sch, LandingGearSchematic_3.brd]
2019-12-04 Code for the landing gear
    WORKING for the leonardo board
2019-12-07 Board Files
2019-12-09 Rearranged the github and placed everything in files
    Final Board Revision is #6 in brd
    Homeworks are placed in Documentation
    Arduino code in code file
    [ECE 411 BoM.xlsx, Landing Gear Layout REV.sch, Landing Gear Layout.brd, Landing Gear Layout.sch, Landing Gear Schematic.sch, Landing Gear Schematic_6.brd, LandingGearSchematic_2.sch, LandingGearSchematic_3.brd]
